lowderd/Lowd-USB-DAC/Lowd_DAC_BOM.xlsx

Bill Of Materials - Lowd USB DAC
Number of Devices: |  | 1
Item # | Designator | Name | Description | Manufacturer | Mfg. Part # | Distributor | Quantity
1 | C1, C3, C7, C9, C12 | 1uF Cap | CAP CER 1UF 16V Y5V 0805 | Samsung Electro-Mechanics America Inc. | CL21F105ZOCNNNC | Digikey | 5
2 | C2 | 10uF Cap | CAP ALUM 10UF 25V 20% SMD | Panasonic Electronic Components | EEE-HA1E100R | Digikey | 1
3 | C4, C5 | 22pF Cap | CAP CER 22PF 50V 5% NP0 0805 | Kernet | C0805C220J5GACTU | Digikey | 2
4 | C6, C8 | 22nF Audio Cap | CAP FILM 0.022UF 50VDC 1210 | Panasonic Electronic Components | ECH-U1H223GX5 | Digikey | 2
5 | C10, C11 | 100uF Audio Cap | CAP ALUM 100UF 25V 20% SMD | Nichicon | UUQ1E101MCL1GS | Digikey | 2
6 | CN1 | Mini USB Conn | CONN MINI USB RCPT RA TYPE B SMD | FCI | 10033526-N3212LF | Digikey | 1
7 | JP2 | Audio Conn | CONN JACK STEREO R/A 3PIN 3.5MM | CUI Inc | SJ1-3523N | Digikey | 1
8 | L1 | Ferrite Bead | FERRITE BEAD 47 OHM 0805 | Taiyo Yuden | BK2125HS470-T | Digikey | 1
9 | LED1, LED2 | Indicator LEDs | LED 468NM BLUE CLEAR 0603 SMD | Lite-On Inc | LTST-C191TBKT | Digikey | 2
10 | Q1 | 12MHz Crystal | CRYSTAL 12MHZ 18PF THRU | TXC Corporation | 9B-12.000MAAJ-B | Digikey | 1
11 | R1 | 1MOhm Resistor | RES SMD 1M OHM 5% 1/8W 0805 | Stackpole Electronics Inc | RMCF0805JT1M00 | Digikey | 1
12 | R2, R4 | 16 Ohm Audio Resistor | RES SMD 16 OHM 1% 1/8W 0805 | Yageo | RC0805FR-0716RL | Digikey | 2
13 | R3, R11 | 1.5KOhm Resistor | RES SMD 1.5K OHM 1% 1/8W 0805 | Yageo | RC0805FR-071K5L | Digikey | 2
14 | R5, R6, R8, R10 | 3.3KOhm Audio Resistor | RES SMD 3.3K OHM 1% 1/8W 0805 | Rohm | MCR10ERTF3301 | Digikey | 4
15 | R7, R9 | 22 Ohm Resistor | RES SMD 22 OHM 1% 1/8W 0805 | Yageo | RC0805FR-0722RL | Digikey | 2
16 | R12 | 560 Ohm Resistor | RES SMD 560 OHM 5% 1/8W 0805 | Stackpole Electronics Inc | RMCF0805JT560R | Digikey | 1
17 | R13 | 330 Ohm Resistor | RES SMD 330 OHM 5% 1/8W 0805 | Stackpole Electronics Inc | RMCF0805JT330R | Digikey | 1
18 | U1 | PCM2707 USB DAC | IC DAC 16BIT STEREO W/USB 32TQFP | Texas Instruments | PCM2707PJTR | Digikey | 1
Mechanical Parts
19 | TOP | Case Top | CASE TOP | Ponoko | N/A | N/A | 1
20 | BOT | Case Bottom | CASE BOTTOM | Ponoko | N/A | N/A | 1
21 | SIDE | Case Sides | CASE SIDE | Ponoko | N/A | N/A | 6
22 | NUT1 | Nut for Case Screw | M3 18-8 STAINLESS STEEL ACORN NUT | McMaster-Carr | 94000A330 | McMaster-Carr | 4
23 | WASH1 | PCB Spacer | M3 NYLON FLAT WASHER | McMaster-Carr | 95610A530 | McMaster-Carr | 8
24 | SCREW1 | Case Screw | M3 16MM STAINLESS STEEL HEX CAP SCREW | McMaster-Carr | 90666A107 | McMaster-Carr | 4
25 | SCREW2 | PCB Screw | M3 10MM STAINLESS STEEL HEX CAP SCREW | McMaster-Carr | 90666A105 | McMaster-Carr | 4
26 | NUT2 | Nut for PCB screw | M3 STAINLESS STEEL HEX NUT | McMaster-Carr | 91828A211 | McMaster-Carr | 4
27 | PCB1 | PCB for USB DAC | PCB | OshPark | N/A | N/A | 1
