lowderd/Lowd-USB-DAC/plastic-case/case-top.stl

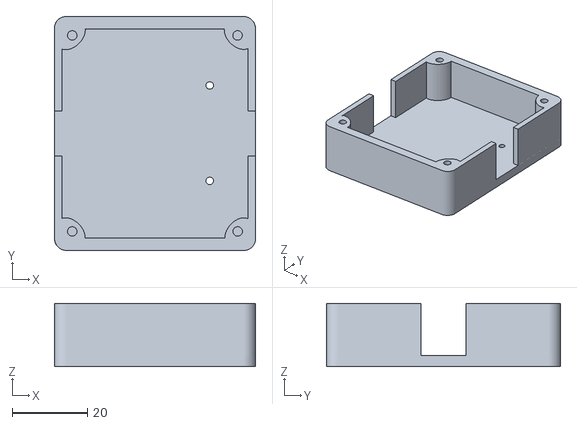
[picture p1: CAD file, 2015-04-09]
plastic-case/case-top.stl
53.6 x 62.3 x 16.9
