lowderd/Lowd-USB-DAC/plastic-case/case-base.stl

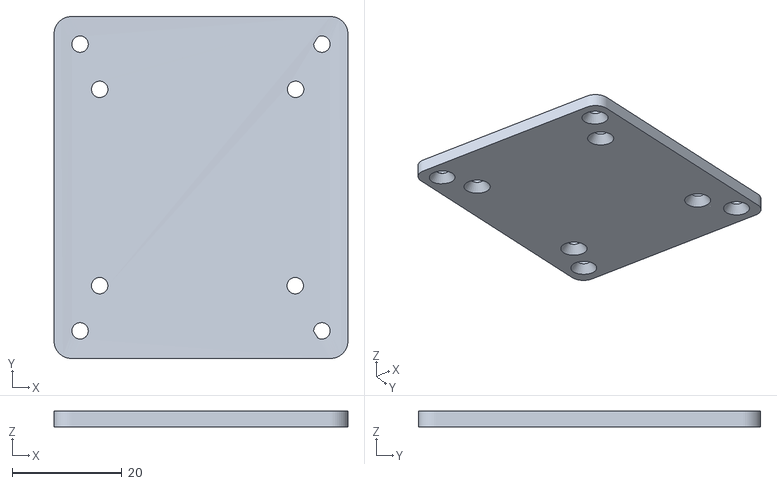
[picture p2: CAD file, 2015-04-09]
plastic-case/case-base.stl
53.5 x 62.3 x 2.89
