lowderd/Lowd-USB-DAC/(list of files, cad)

Other CAD files:
PCM2707_Rev2.skp
plastic-case/plastic-case.blend
