lowderd/Lowd-USB-DAC/PCM2707C_HeadPhone_V2.brd

## EAGLE design PCM2707C_HeadPhone_V2.brd (2015-01-23)

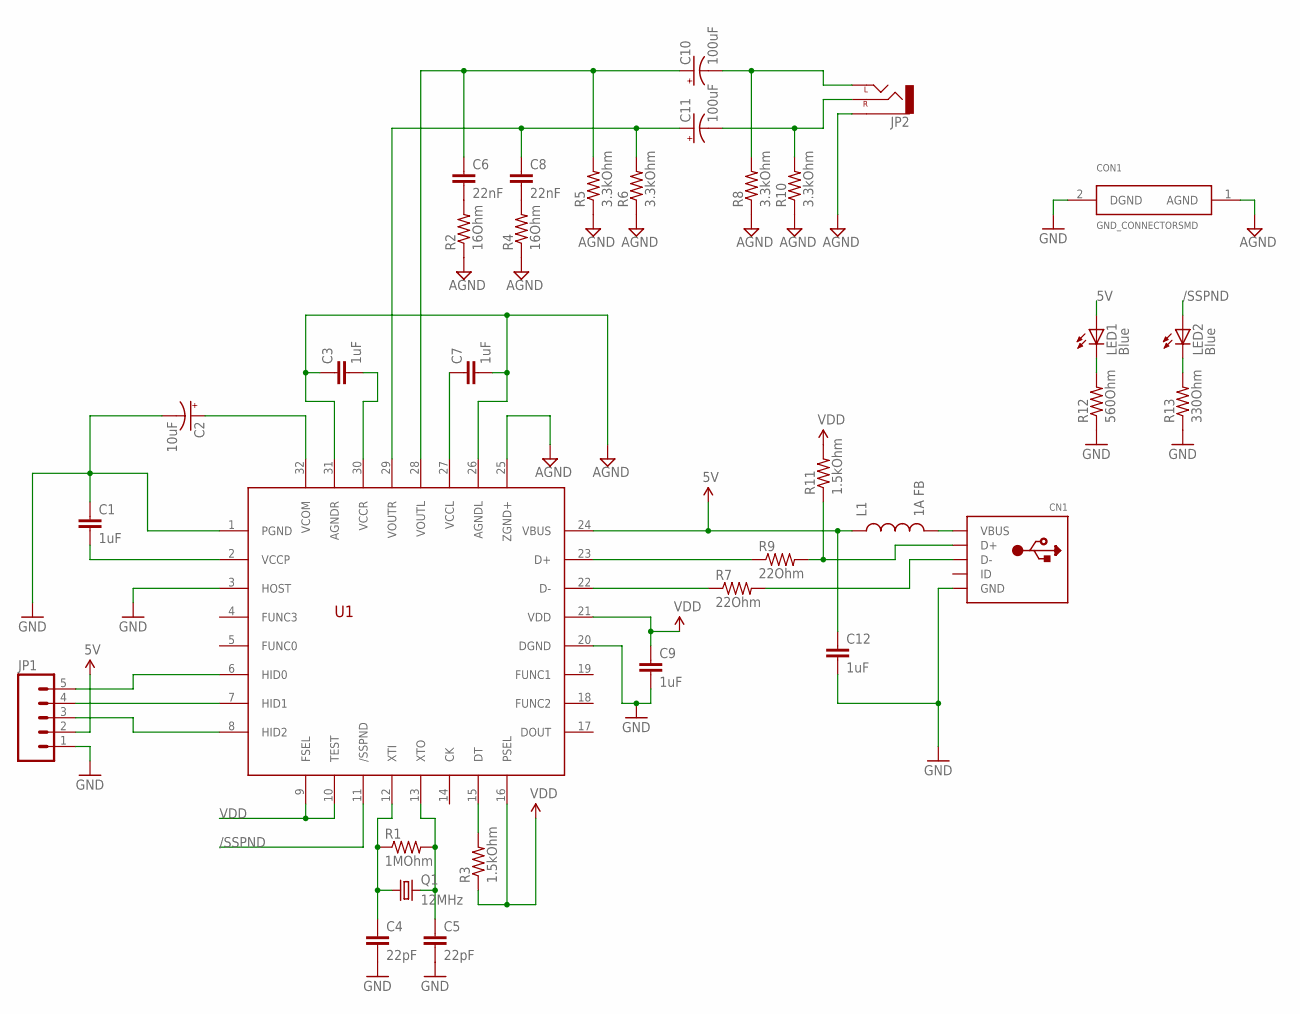
[picture p3: schematic PCM2707C_HeadPhone_V2.sch]

Parts:
C1, C3, C7, C9, C12: 1uF; 0805
C2: 10uF; PANASONIC_C
C4, C5: 22pF; 0805
C6, C8: 22nF; 1210
C10, C11: 100uF; PANASONIC_D
CN1: USBMINIB; USB-MINIB
CON1: GND_CONNECTORSMD; GND_CONNECTOR
JP1: M05LOCK; 1X05_LOCK
JP2: AUDIO-JACKPTH; AUDIO-JACK
L1: 1A FB; 0805
LED1, LED2: Blue; LED-0603
Q1: 12MHz; HC49U-V
R1: 1MOhm; 0805
R2, R4: 16Ohm; 0805
R3, R11: 1.5kOhm; 0805
R5, R6, R8, R10: 3.3kOhm; 0805
R7, R9: 22Ohm; 0805
R12: 560Ohm; 0805
R13: 330Ohm; 0805
U1: PCM2707C_TQFP32"; 32TQFP_PCM2707C

Connections:
5V: C12.1, JP1.2, L1.1, LED1.A, U1.24 (VBUS)
/SSPND: LED2.A, U1.11 (/SSPND)
AGND: C3.1, C7.2, CON1.1 (AGND), JP2.SLEEVE, R2.1, R4.1, R5.1, R6.1, R8.1, R10.1, U1.25 (ZGND+), U1.26 (AGNDL), U1.31 (AGNDR)
GND: C1.1, C2.-, C4.2, C5.2, C9.2, C12.2, CN1.GND, CON1.2 (DGND), JP1.1, R12.1, R13.1, U1.1 (PGND), U1.3 (HOST), U1.20 (DGND)
unnamed: JP1.5, U1.6 (HID0)
unnamed: C1.2, U1.2 (VCCP)
unnamed: JP1.4, U1.7 (HID1)
unnamed: C2.+, U1.32 (VCOM)
unnamed: JP1.3, U1.8 (HID2)
unnamed: CN1.VBUS, L1.2
unnamed: C4.1, Q1.1, R1.1, U1.12 (XTI)
unnamed: C5.1, Q1.2, R1.2, U1.13 (XTO)
unnamed: R9.1, U1.23 (D+)
unnamed: R7.1, U1.22 (D-)
unnamed: CN1.D+, R9.2, R11.1
unnamed: CN1.D-, R7.2
unnamed: C3.2, U1.30 (VCCR)
unnamed: LED1.C, R12.2
unnamed: R3.2, U1.15 (DT)
unnamed: C7.1, U1.27 (VCCL)
unnamed: C8.2, R4.2
unnamed: C6.2, R2.2
unnamed: C11.-, JP2.RING (RIGHT), R10.2
unnamed: C10.-, JP2.TIP (LEFT), R8.2
unnamed: C8.1, C11.+, R6.2, U1.29 (VOUTR)
unnamed: LED2.C, R13.2
unnamed: C6.1, C10.+, R5.2, U1.28 (VOUTL)
VDD: C9.1, R3.1, R11.2, U1.9 (FSEL), U1.10 (TEST), U1.16 (PSEL), U1.21 (VDD)

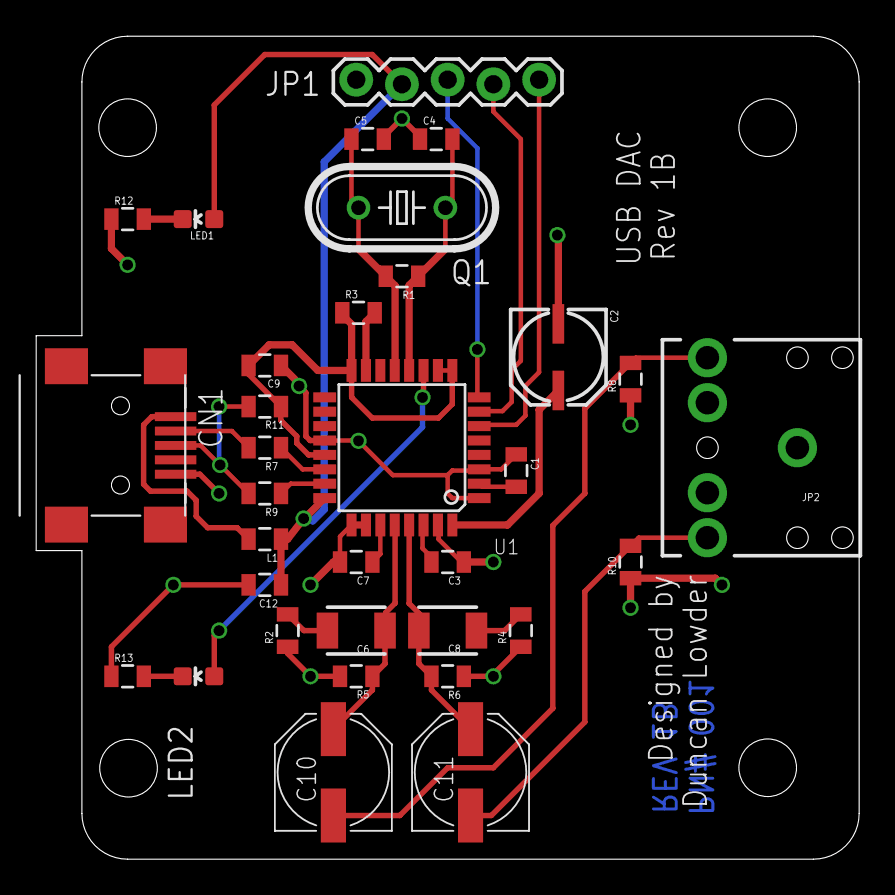
[picture p4: board PCM2707C_HeadPhone_V2.brd from above]

Board: 2 copper layers, 45.7 x 45.7 mm, 34 parts (1 on the bottom side), 28 nets.
