lowderd/Lowd-USB-DAC/(commit log)

2015-03-12 3d platic model
    A new design for the board's case, because I didn't like the original
    design.
    [case-base.stl, case-top.stl, plastic-case.blend]
2015-03-12 readme modify for the screw to show
